anobli/beal-hw/Beal-TX/Beal-TX.kicad_pcb

## KiCad design Beal-TX/Beal-TX.kicad_pcb (2026-10-19)

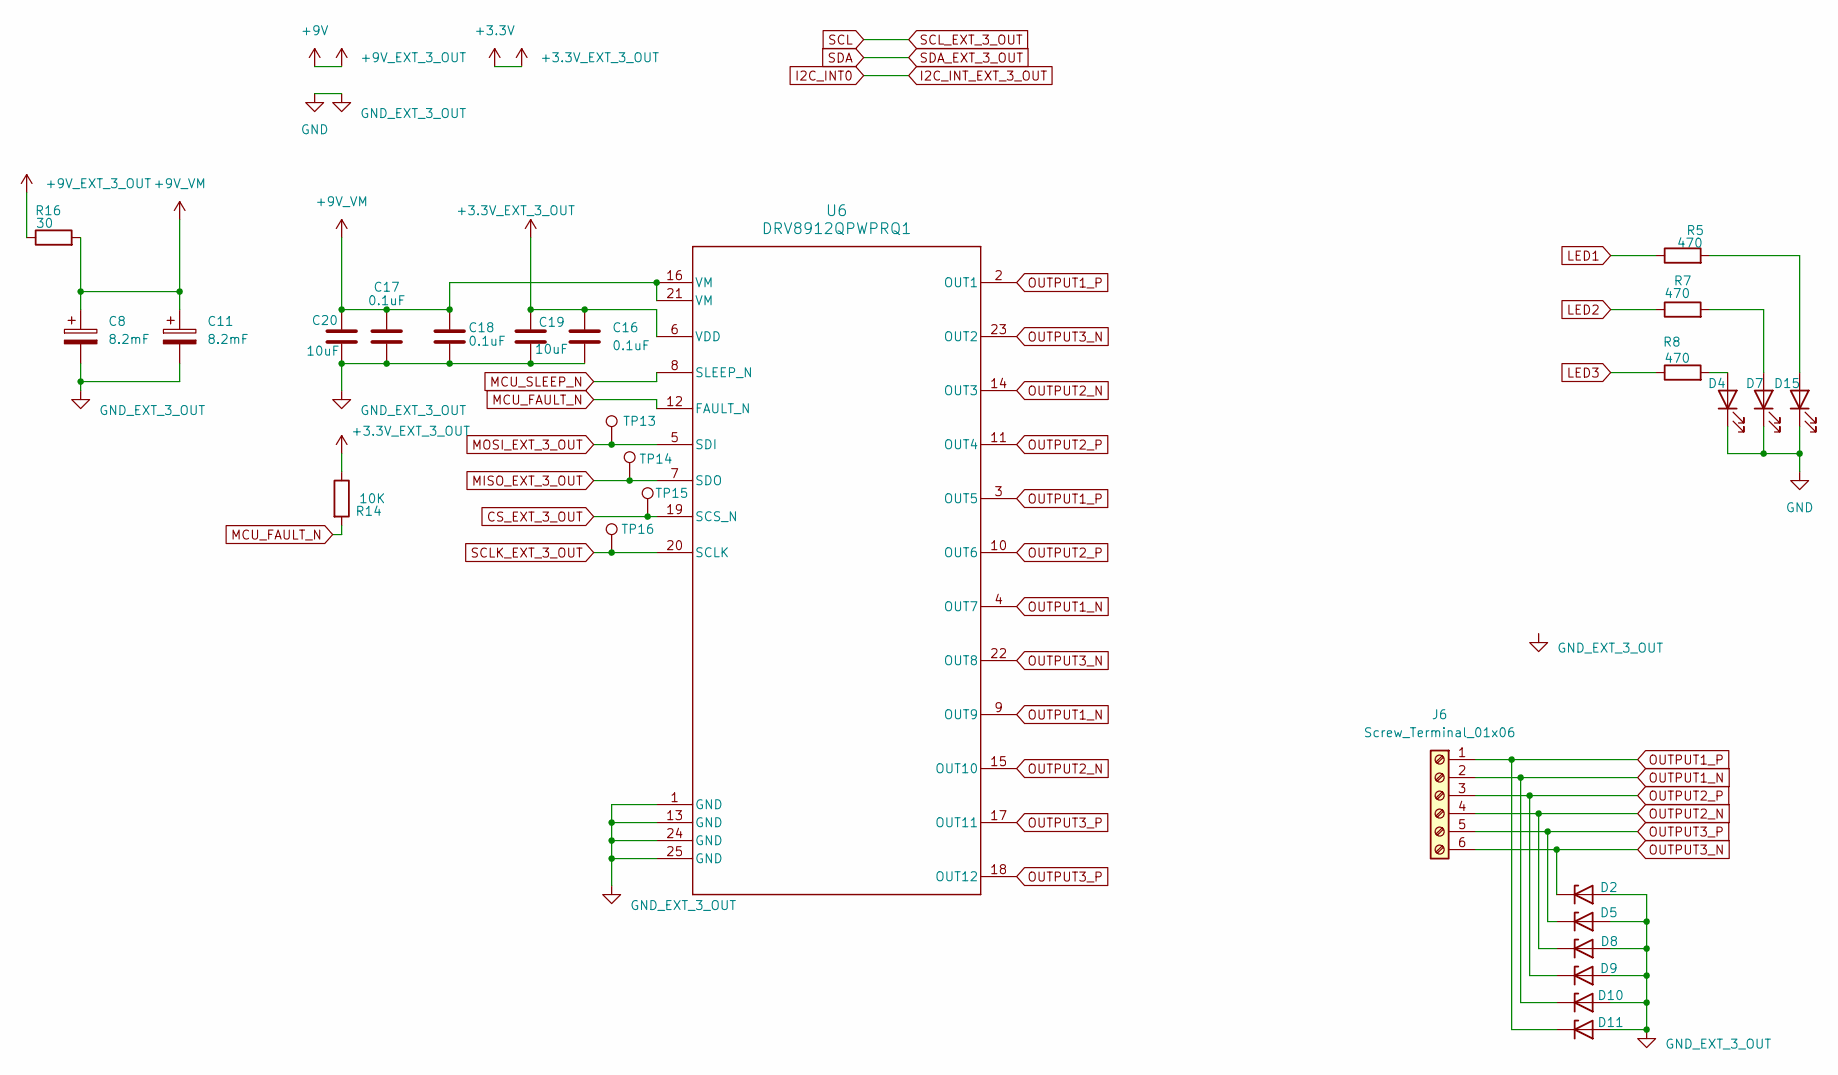
[picture p1: schematic input.kicad_sch, Baal - LoRa valve controler]

Parts:
C8, C11: 8.2mF; CP_Radial_D25.0mm_P10.00mm_SnapIn; MPN 8.2mF 35V
C16: 0.1uF; C_0402_1005Metric; Manufacturer_Part_Number 0,1uF 16V 0402
C17, C18: 0.1uF; C_0805_2012Metric; Manufacturer_Part_Number 0,1uF 50V 0805
C19: 10uF; C_0805_2012Metric; MPN 10uF 10V 0805
C20: 10uF; C_1206_3216Metric; MPN GRM31CR71C106KAC7L
D2, D5, D8, D9, D10, D11: ESD9X12ST5G; D_SOD-923; MPN SZESD9X12ST5G
D4, D7, D15: LED; LED_0603_1608Metric; Manufacturer_Part_Number led red 1206
J6: Screw_Terminal_01x06; 691401710006B; MPN 691401710006B
R5, R7, R8: 470; R_0402_1005Metric; MPN 470 0402
R14: 10K; R_0402_1005Metric; MPN 10K 0402
R16: 30; R_2512_6332Metric; MPN 30R 1% 2512 3W
TP13, TP14, TP15, TP16: TestPoint; TestPoint_Pad_D1.0mm
U6: DRV8912QPWPRQ1; HTSSOP-24-1EP_4.4x7.8mm_P0.65mm_EP3.4x7.8mm_Mask2.4x4.68mm_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; Manufacturer_Part_Number DRV8912QPWPRQ1

Connections:
+3.3V: C16.1, C19.1, R14.1, U6.6 (VDD); also elsewhere on the board
+9V: R16.1; also elsewhere on the board
+9V_VM: C8.1, C11.1, C17.1, C18.1, C20.1, R16.2, U6.16 (VM), U6.21 (VM)
CS_EXT_3_OUT: TP15.1 (1_1), U6.19 (SCS_N); also elsewhere on the board
GND: C8.2, C11.2, C16.2, C17.2, C18.2, C19.2, C20.2, D2.2 (A), D4.1 (K), D5.2 (A), D7.1 (K), D8.2 (A), D9.2 (A), D10.2 (A), D11.2 (A), D15.1 (K), U6.1 (GND), U6.13 (GND), U6.24 (GND), U6.25 (GND); also elsewhere on the board
LED1: R5.1; also elsewhere on the board
LED2: R7.1; also elsewhere on the board
LED3: R8.1; also elsewhere on the board
MCU_FAULT_N: R14.2, U6.12 (FAULT_N); also elsewhere on the board
MCU_SLEEP_N: U6.8 (SLEEP_N); also elsewhere on the board
MISO_EXT_3_OUT: TP14.1 (1_1), U6.7 (SDO); also elsewhere on the board
MOSI_EXT_3_OUT: TP13.1 (1_1), U6.5 (SDI); also elsewhere on the board
unnamed: D4.2 (A), R8.2
unnamed: D7.2 (A), R7.2
unnamed: D15.2 (A), R5.2
OUTPUT1_N: D10.1 (K), J6.2, U6.4 (OUT7), U6.9 (OUT9)
OUTPUT1_P: D11.1 (K), J6.1, U6.2 (OUT1), U6.3 (OUT5)
OUTPUT2_N: D8.1 (K), J6.4, U6.14 (OUT3), U6.15 (OUT10)
OUTPUT2_P: D9.1 (K), J6.3, U6.10 (OUT6), U6.11 (OUT4)
OUTPUT3_N: D2.1 (K), J6.6, U6.22 (OUT8), U6.23 (OUT2)
OUTPUT3_P: D5.1 (K), J6.5, U6.17 (OUT11), U6.18 (OUT12)
SCLK_EXT_3_OUT: TP16.1 (1_1), U6.20 (SCLK); also elsewhere on the board

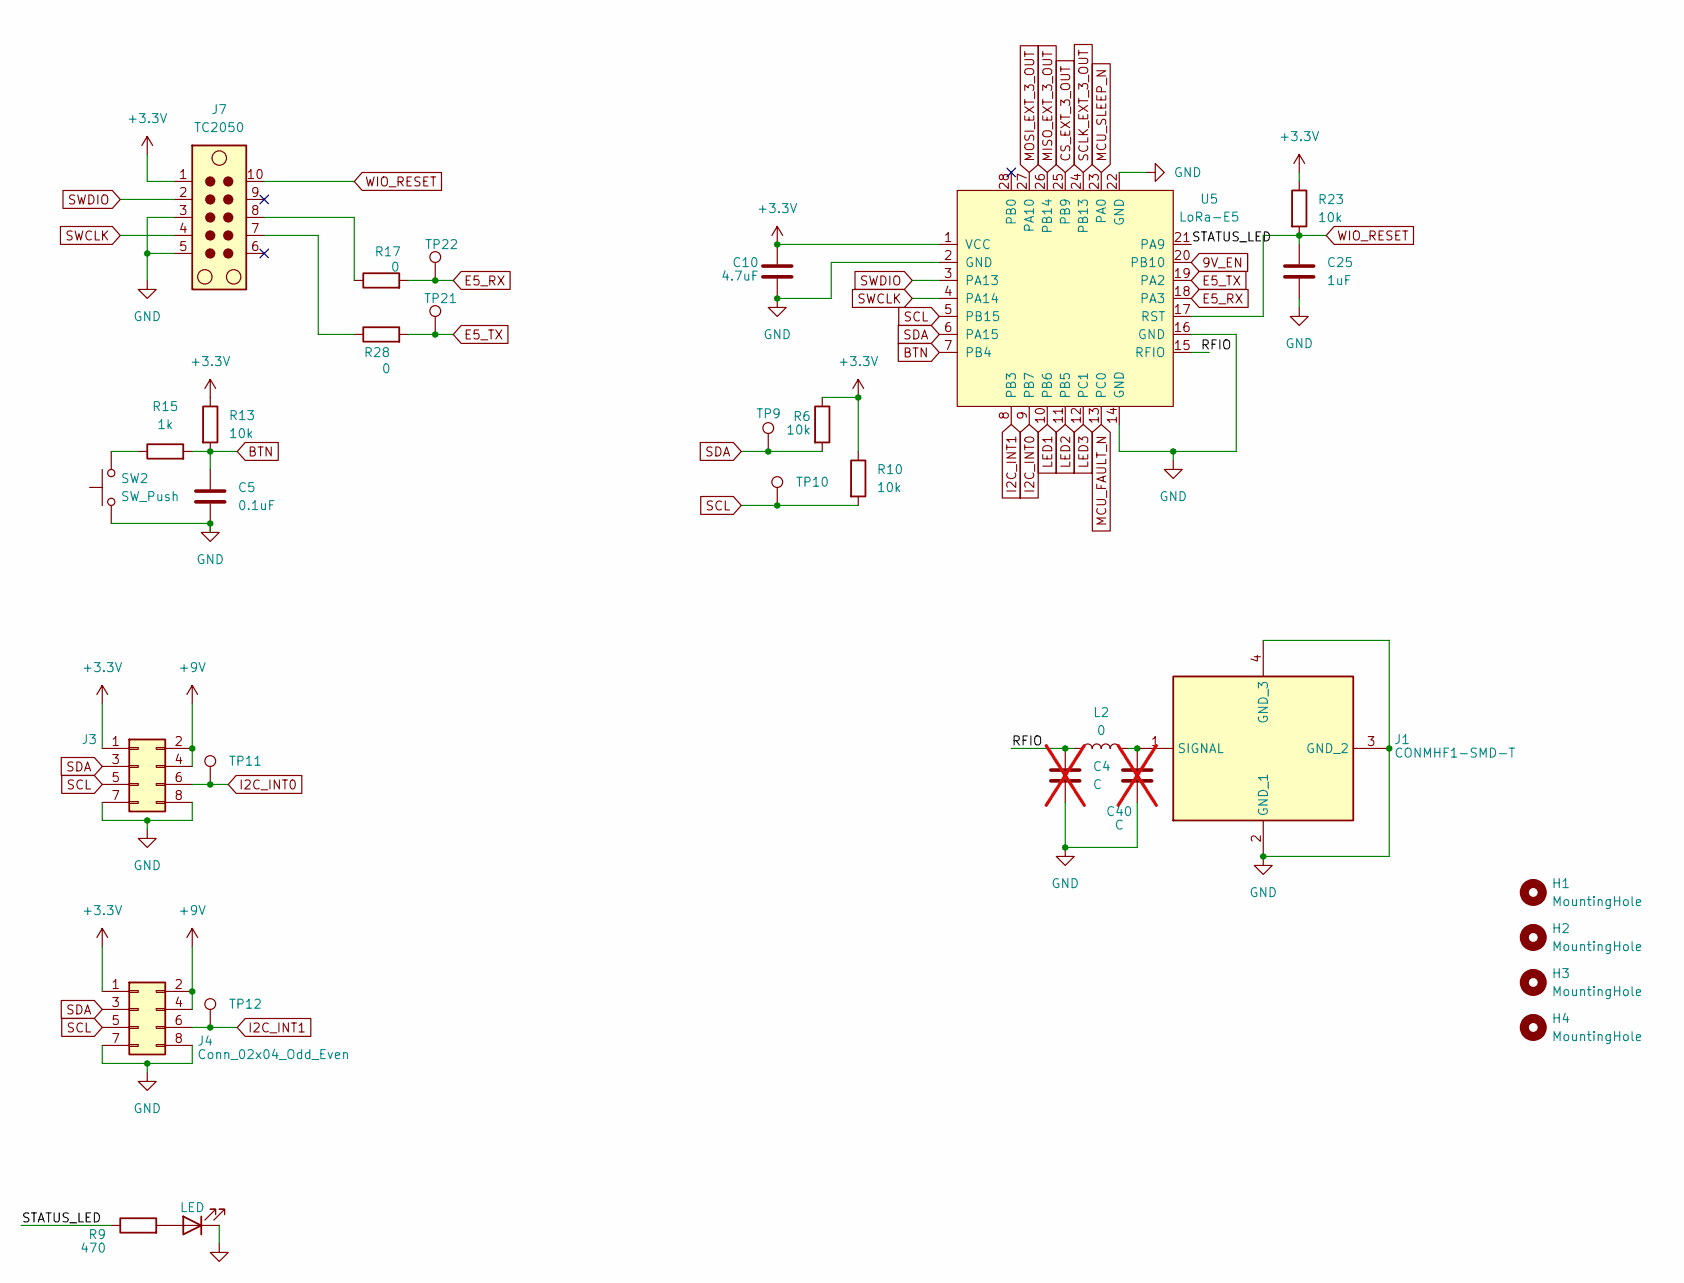
[picture p2: schematic radio_mcu.kicad_sch]

Parts:
C4, C40: C; C_0603_1608Metric; not fitted
C5: 0.1uF; C_0805_2012Metric; MPN 0.1uF 16V 0805
C10: 4.7uF; C_0805_2012Metric; MPN 4.7uF 10V 0805
C25: 1uF; C_0603_1608Metric; Manufacturer_Part_Number 1uF 16V 0603
D3: LED; LED_0603_1608Metric; Manufacturer_Part_Number led red 1206
H1, H2, H3, H4: MountingHole; MountingHole_2.1mm
J1: CONMHF1-SMD-T; CONMHF1SMDT; Mouser Part Number 712-CONMHF1-SMD-T
J3, J4: Conn_02x04_Odd_Even; PinHeader_2x04_P1.00mm_Vertical_SMD
J7: TC2050; Tag-Connect_TC2050-IDC-NL_2x05_P1.27mm_Vertical
L2: 0; L_0603_1608Metric; MPN 0201WMF0000TEE
R6, R10: 10k; R_0402_1005Metric; MPN 10k 0402
R9: 470; R_0402_1005Metric; MPN 470 0402
R13: 10k; R_0402_1005Metric; MPN 10K 0402
R15: 1k; R_0402_1005Metric; MPN 1k 0402
R17, R28: 0; R_0402_1005Metric; MPN 0 0402
R23: 10k; R_0402_1005Metric; Manufacturer_Part_Number 10K 0402
SW2: SW_Push; SW_PUSH_6mm; MPN TS02-66-43-BK-160-LCR-D
TP9, TP10, TP11, TP12, TP21, TP22: TestPoint; TestPoint_Pad_D1.0mm
U5: LoRa-E5; MPN LORA-E5 LORAWAN MODULE

Connections:
9V_EN: U5.20 (PB10); also elsewhere on the board
+3.3V: C10.1, J3.1, J4.1, J7.1, R6.1, R10.1, R13.1, R23.1, U5.1 (VCC); also elsewhere on the board
+9V: J3.2, J3.4, J4.2, J4.4; also elsewhere on the board
/Radio_MCU/RFIO: C4.1, L2.1, U5.15 (RFIO)
/Radio_MCU/STATUS_LED: R9.1, U5.21 (PA9)
BTN: C5.1, R13.2, R15.2, U5.7 (PB4)
CS_EXT_3_OUT: U5.25 (PB9); also elsewhere on the board
E5_RX: R17.2, TP22.1 (1_1), U5.18 (PA3)
E5_TX: R28.2, TP21.1 (1_1), U5.19 (PA2)
GND: C4.2, C5.2, C10.2, C25.2, C40.2, D3.1 (K), J1.2 (GND_1), J1.3 (GND_2), J1.4 (GND_3), J3.7, J3.8, J4.7, J4.8, J7.3, J7.5, SW2.1, U5.2 (GND), U5.14 (GND), U5.16 (GND), U5.22 (GND); also elsewhere on the board
I2C_INT0: J3.6, TP11.1 (1_1), U5.9 (PB7)
I2C_INT1: J4.6, TP12.1 (1_1), U5.8 (PB3)
LED1: U5.10 (PB6); also elsewhere on the board
LED2: U5.11 (PB5); also elsewhere on the board
LED3: U5.12 (PC1); also elsewhere on the board
MCU_FAULT_N: U5.13 (PC0); also elsewhere on the board
MCU_SLEEP_N: U5.23 (PA0); also elsewhere on the board
MISO_EXT_3_OUT: U5.26 (PB14); also elsewhere on the board
MOSI_EXT_3_OUT: U5.27 (PA10); also elsewhere on the board
unnamed: D3.2 (A), R9.2
unnamed: C40.1, J1.1 (SIGNAL), L2.2
unnamed: J7.7, R28.1
unnamed: J7.8, R17.1
unnamed: R15.1, SW2.2
SCL: J3.5, J4.5, R10.2, TP10.1 (1_1), U5.5 (PB15)
SCLK_EXT_3_OUT: U5.24 (PB13~); also elsewhere on the board
SDA: J3.3, J4.3, R6.2, TP9.1 (1_1), U5.6 (PA15)
SWCLK: J7.4, U5.4 (PA14)
SWDIO: J7.2, U5.3 (PA13)
WIO_RESET: C25.1, J7.10, R23.2, U5.17 (RST)

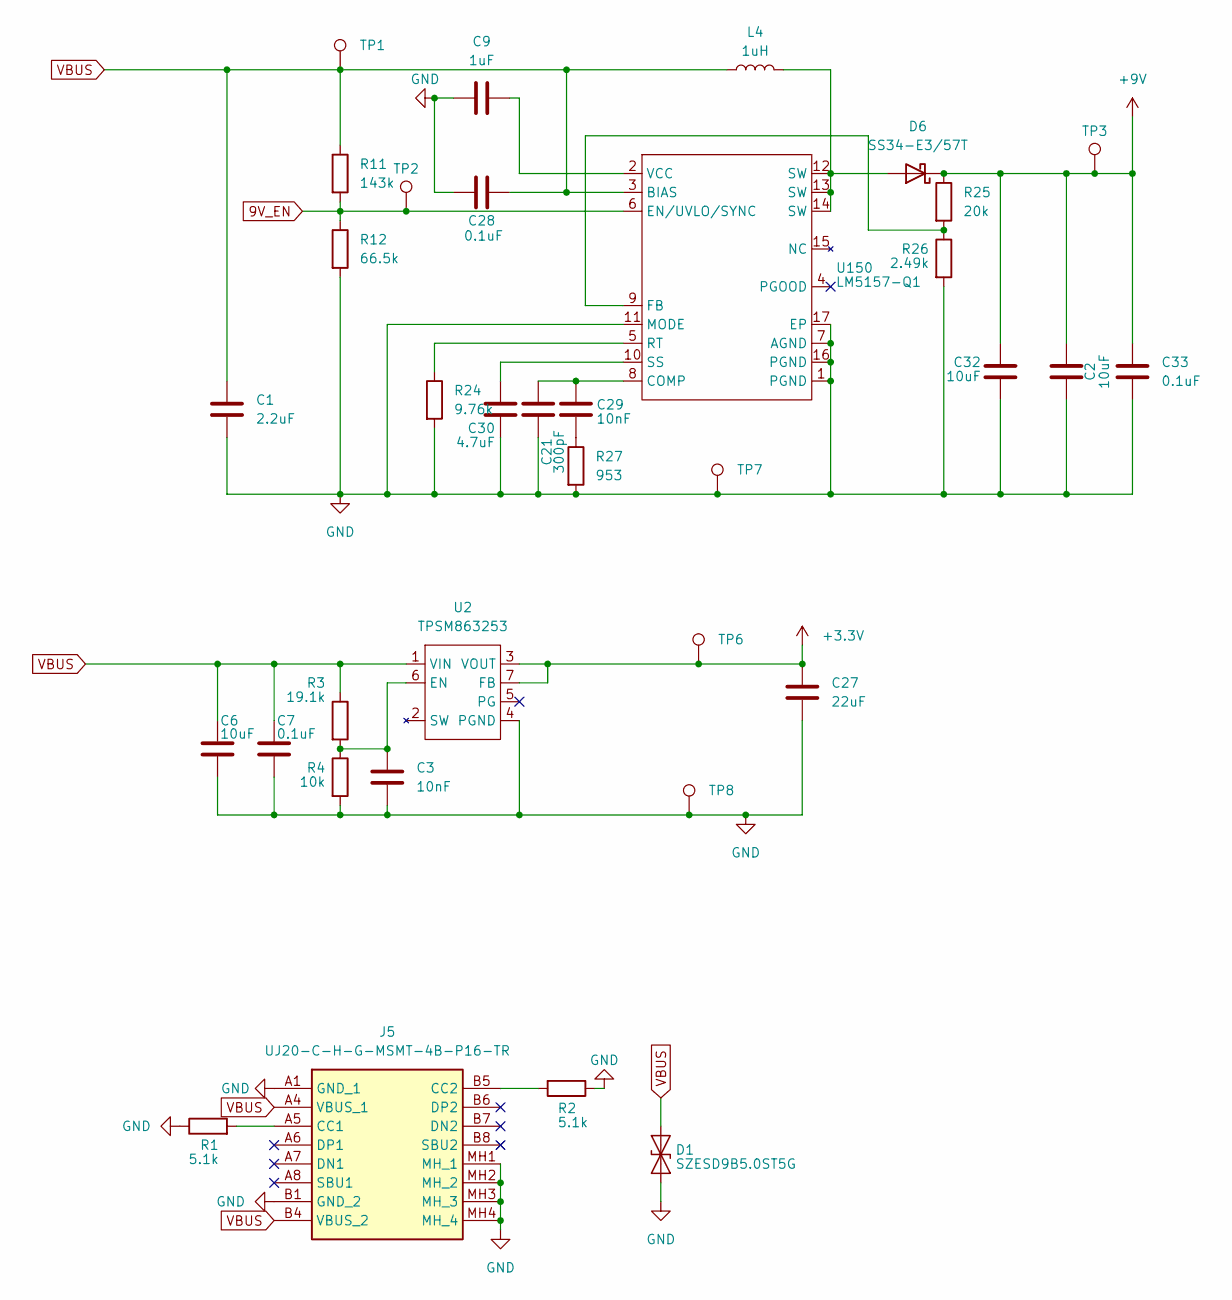
[picture p3: schematic power.kicad_sch]

Parts:
C1: 2.2uF; C_0805_2012Metric; Manufacturer_Part_Number GRM21BR71A225KA01L
C2, C32: 10uF; C_1206_3216Metric; Manufacturer_Part_Number GRM31CR71C106KAC7L
C3: 10nF; C_0402_1005Metric; Manufacturer_Part_Number GRM155R71C103KA01D
C6: 10uF; C_0805_2012Metric; Manufacturer_Part_Number C0805C106K8PACTU
C7: 0.1uF; C_0805_2012Metric; Manufacturer_Part_Number 08053C104KAT2A
C9: 1uF; C_0603_1608Metric; Manufacturer_Part_Number EMK107B7105KA-T
C21: 300pF; C_0402_1005Metric; Manufacturer_Part_Number GRM1555C1E301JA01D
C27: 22uF; C_0805_2012Metric; Manufacturer_Part_Number MSASL219LB5226MTNA01
C28: 0.1uF; C_0402_1005Metric; Manufacturer_Part_Number GRM155R71A104KA01D
C29: 10nF; C_0402_1005Metric; Manufacturer_Part_Number GRM155R70J103KA01D
C30: 4.7uF; C_0402_1005Metric; Manufacturer_Part_Number 4.7uF 16V
C33: 0.1uF; C_0805_2012Metric; Manufacturer_Part_Number GRM155R71C104KA88D
D1: SZESD9B5.0ST5G; D_SOD-923; MPN SZESD9B5.0ST5G
D6: SS34-E3/57T; D_SMB; Manufacturer_Part_Number SS34-E3/57T
J5: UJ20-C-H-G-MSMT-4B-P16-TR; UJ20CHGMSMT4BP16TR; Manufacturer_Part_Number UJ20-C-H-G-MSMT-4B-P16-TR
L4: 1uH; L_Wuerth_WE-PD-Typ-7345; Manufacturer_Part_Number 744777001
R1, R2: 5.1k; R_0402_1005Metric; Manufacturer_Part_Number 5.1K 0402
R3: 19.1k; R_0402_1005Metric; Manufacturer_Part_Number CRCW040219K1FKED
R4: 10k; R_0402_1005Metric; Manufacturer_Part_Number CRCW040210K0FKED
R11: 143k; R_0402_1005Metric; MPN 143k 0402
R12: 66.5k; R_0402_1005Metric; MPN 66.5k 0402
R24: 9.76k; R_0402_1005Metric; Manufacturer_Part_Number CRCW04029K76FKED
R25: 20k; R_0402_1005Metric; Manufacturer_Part_Number CRCW040220K0FKED
R26: 2.49k; R_0402_1005Metric; Manufacturer_Part_Number CRCW04022K49FKED
R27: 953; R_0402_1005Metric; Manufacturer_Part_Number CRCW0402953RFKED
TP1, TP2, TP3, TP6, TP7, TP8: TestPoint; TestPoint_Pad_D1.0mm
U2: TPSM863253; Texas_RDX0007A_QFN-FCMOD-7-3.3x4mm-P0.5mm_4EP; MPN TPSM863253RDXR
U150: LM5157-Q1; WQFN-16-1EP_3x3mm_P0.5mm_EP1.68x1.68mm_ThermalVias; Manufacturer_Part_Number LM5157QRTERQ1

Connections:
9V_EN: R11.2, R12.1, TP2.1 (1_1), U150.6 (EN/UVLO/SYNC); also elsewhere on the board
+3.3V: C27.1, TP6.1 (1_1), U2.3 (VOUT), U2.7 (FB); also elsewhere on the board
+9V: C2.1, C32.1, C33.1, D6.1 (K), R25.1, TP3.1 (1_1); also elsewhere on the board
GND: C1.2, C2.2, C3.2, C6.2, C7.2, C9.2, C21.2, C27.2, C28.1, C30.2, C32.2, C33.2, D1.1 (A1), J5.A1 (GND_1), J5.B1 (GND_2), J5.MH1 (MH_1), J5.MH2 (MH_2), J5.MH3 (MH_3), J5.MH4 (MH_4), R1.1, R2.1, R4.2, R12.2, R24.2, R26.2, R27.2, TP7.1 (1_1), TP8.1 (1_1), U2.4 (PGND), U150.1 (PGND), U150.7 (AGND), U150.11 (MODE), U150.16 (PGND), U150.17 (EP); also elsewhere on the board
unnamed: C29.2, R27.1
unnamed: D6.2 (A), L4.2, U150.12 (SW), U150.13 (SW), U150.14 (SW)
unnamed: J5.A5 (CC1), R1.2
unnamed: J5.B5 (CC2), R2.2
unnamed: C3.1, R3.2, R4.1, U2.6 (EN)
unnamed: C21.1, C29.1, U150.8 (COMP)
unnamed: R25.2, R26.1, U150.9 (FB)
unnamed: R24.1, U150.5 (RT)
unnamed: C30.1, U150.10 (SS)
unnamed: C9.1, U150.2 (VCC)
VBUS: C1.1, C6.1, C7.1, C28.2, D1.2 (A2), J5.A4 (VBUS_1), J5.B4 (VBUS_2), L4.1, R3.1, R11.1, TP1.1 (1_1), U2.1 (VIN), U150.3 (BIAS)

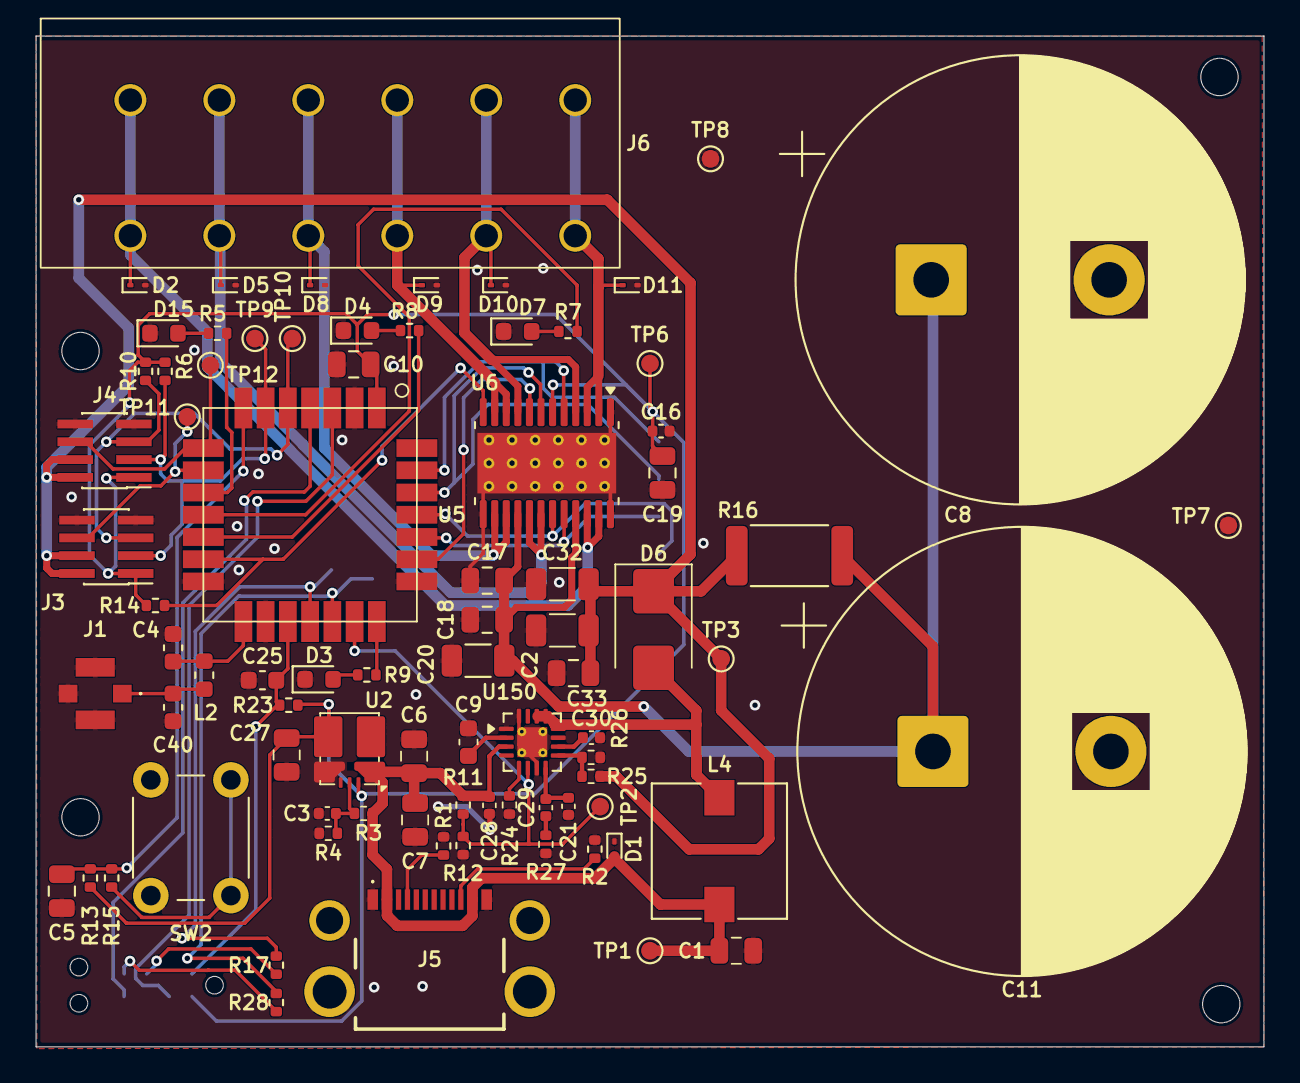
[picture p4: board Beal-TX.kicad_pcb from above]

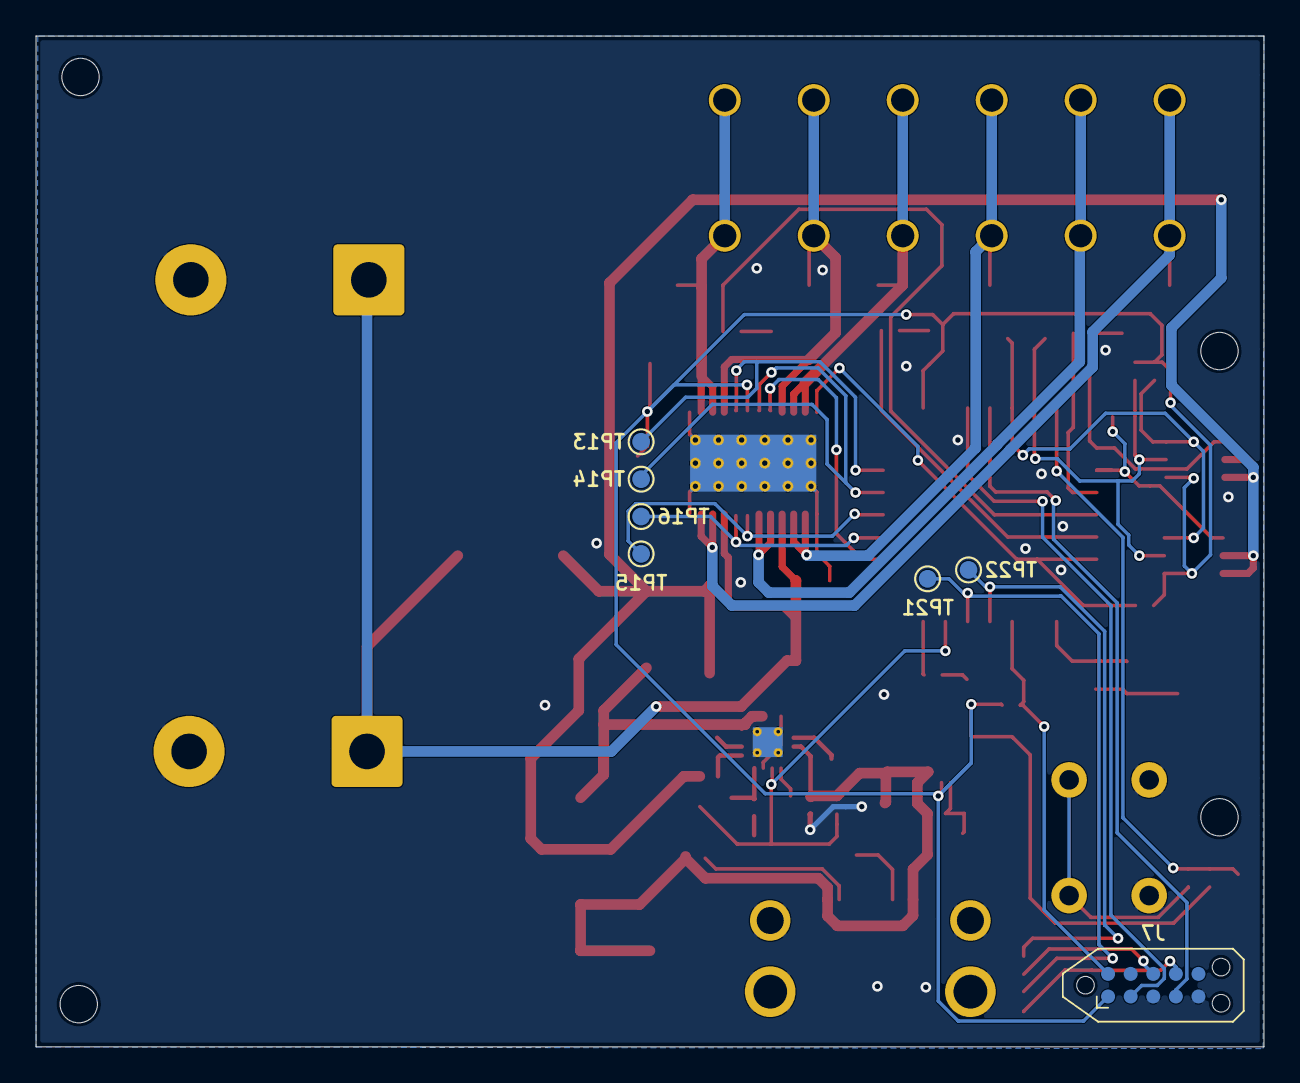
[picture p5: board Beal-TX.kicad_pcb from below]

Board: 2 copper layers, 69.0 x 56.8 mm, 93 parts (7 on the bottom side), 51 nets.
