anobli/beal-hw/(commit log)

2026-10-13 Beal TX: Address some issues found during prototyping phase
    Basically, the prototyping phase has highlighted some issues.
    The major one is about the power delivered by an USB-C battery
    is not enough to safely driver the valve.
    The power after 9V decrease to about 5V, and the 5V from battery
    fall to 2.0V.
    One way for fixing it is using super capacitor.
    This adds an extra cost to the BOM, and, I am not about its
    duration regarding the operating conditions.
    Because of the cost and the doubt about the longevity,
    I would like to evaluate other solutions.
    But, we also need to move forward so I made some changes to
    power to make it more configurable so we could later try external
    battery with a B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
2026-10-19 Beal-TX: Remove changes previoulsy done regarding done regarding battery tests
    I made some measurement on comptitor product and finaly,
    the signal to control the valve is not that bad.
    I have decided to just add a capacitor and to remove all the
    tests features added by previous commit.
    This also tries to address some potential issues and does some
    improvements such as increasing traces for VBUS and +9V.
2026-10-19 Beal TX: Do cosmetic cleanup schematics and pcb
    In order to make schematics and silkscreen easier to read,
    move labels on schematics and slilkscreen on PCB.
2026-10-19 CI: Generate JLCPCB fabrication and assembly files
    Add a jlcpcb job that exports, for each board, a Gerber + drill zip,
    a BOM and a placement (CPL) file using JLCPCB column names, so the
    design can be quoted quickly from the workflow artifacts.
